cspwcspw/DIY_Constant_Load_Controller/Images/Amplify_and_level_shift.png

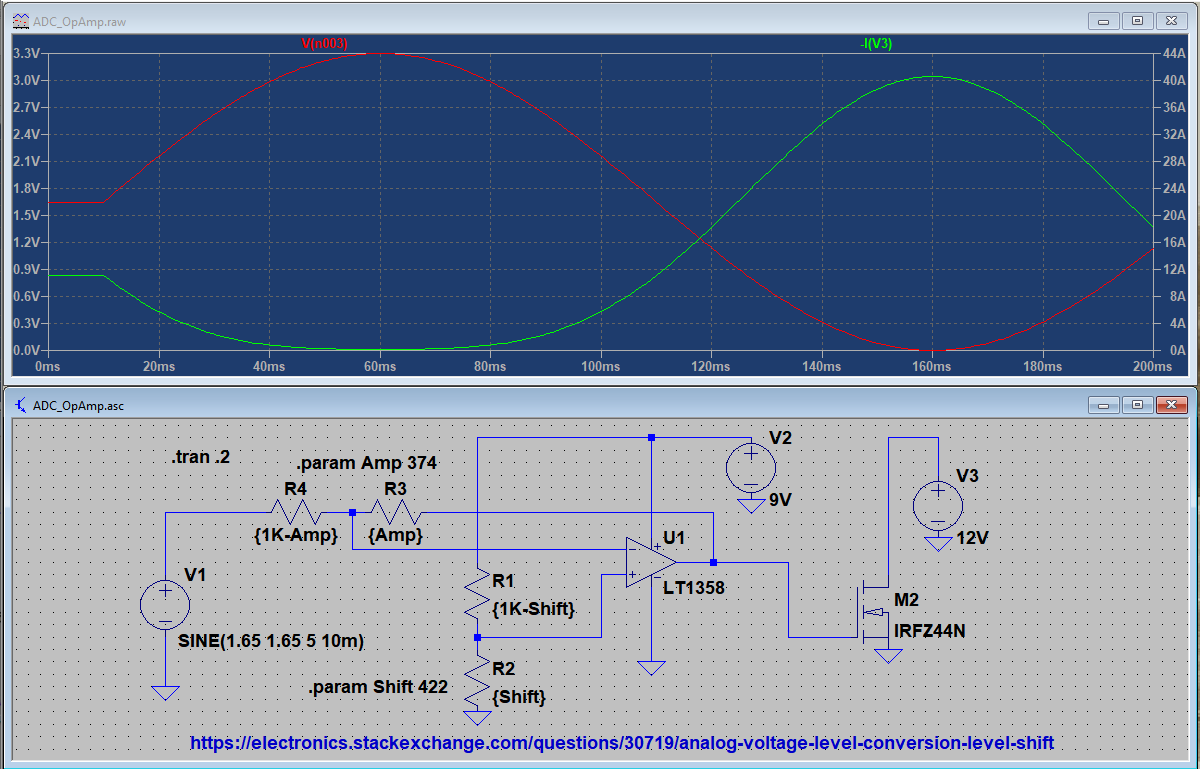
Images/Amplify_and_level_shift.png
