cspwcspw/DIY_Constant_Load_Controller/Images/Amplify_and_level_shift_low.png

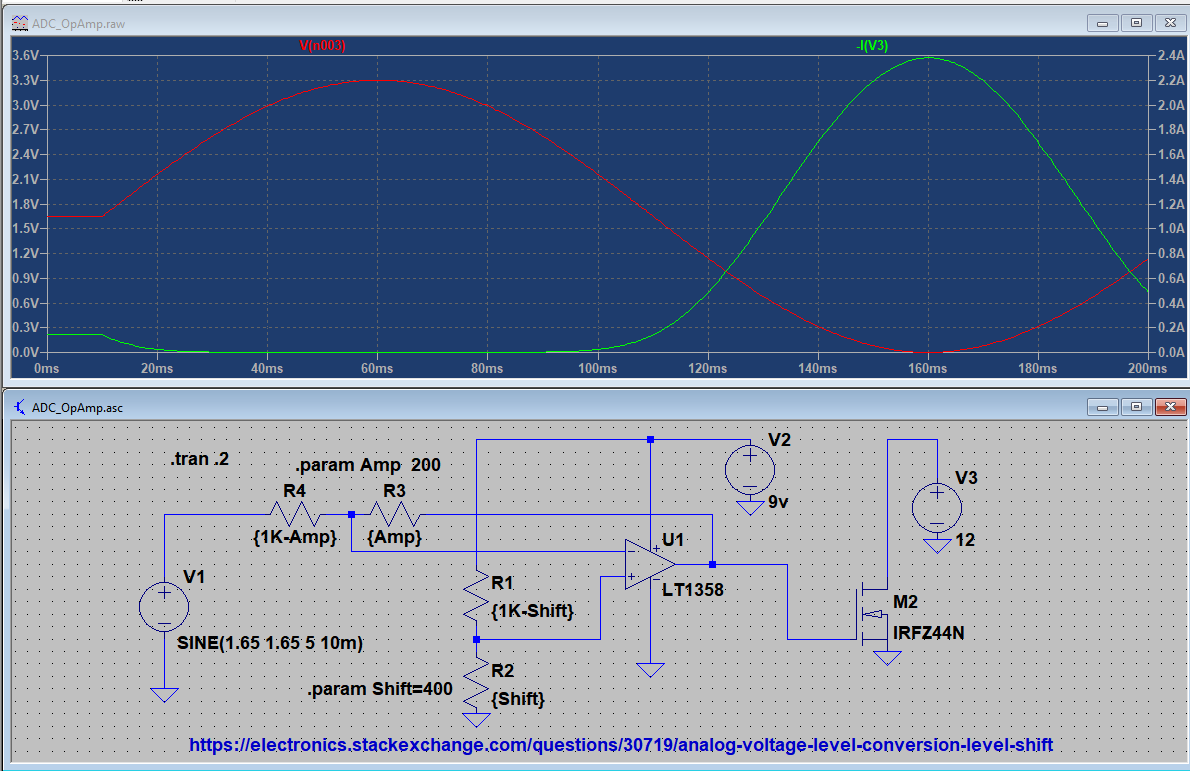
Images/Amplify_and_level_shift_low.png
