cspwcspw/DIY_Constant_Load_Controller/Images/DAC_NoAmp.png

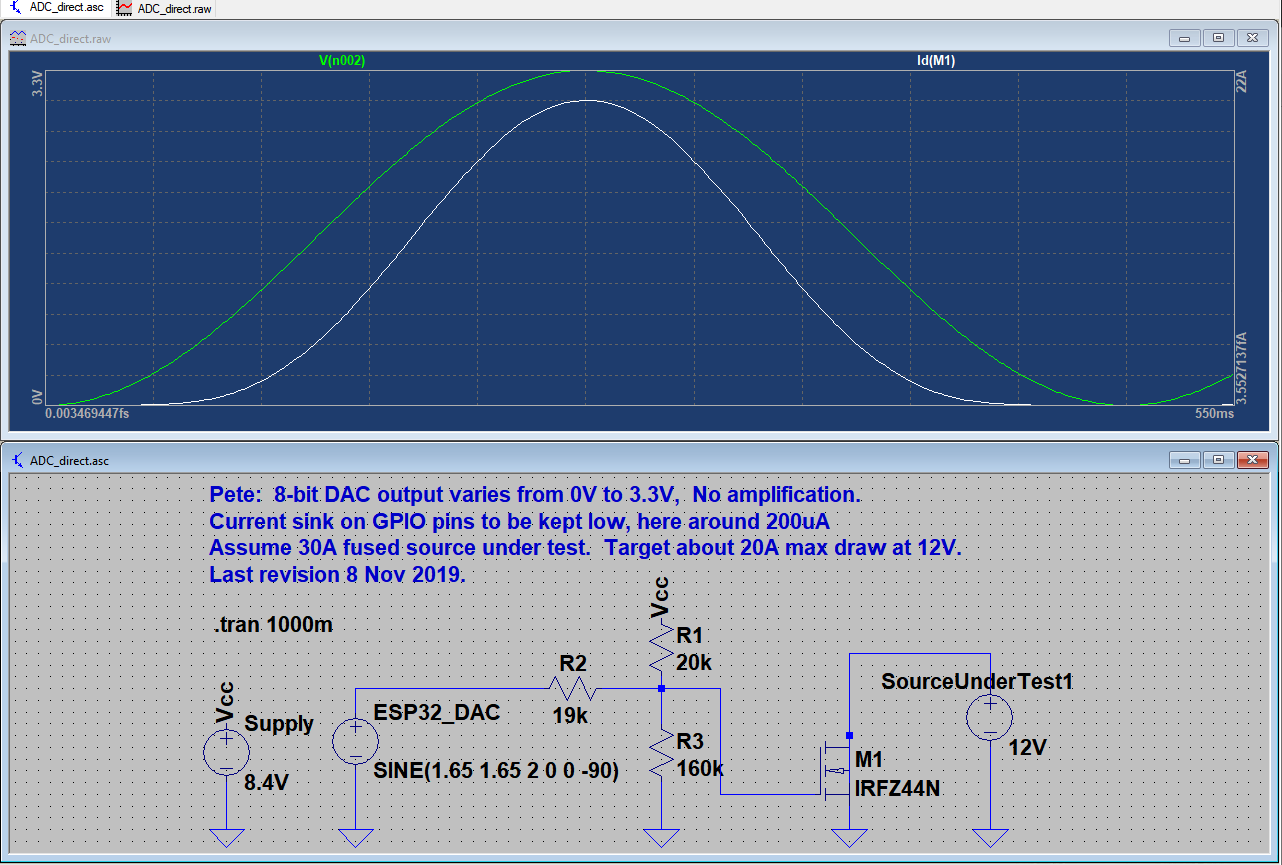
Images/DAC_NoAmp.png
