cspwcspw/DIY_Constant_Load_Controller/Images/NoAmp_PWM.png

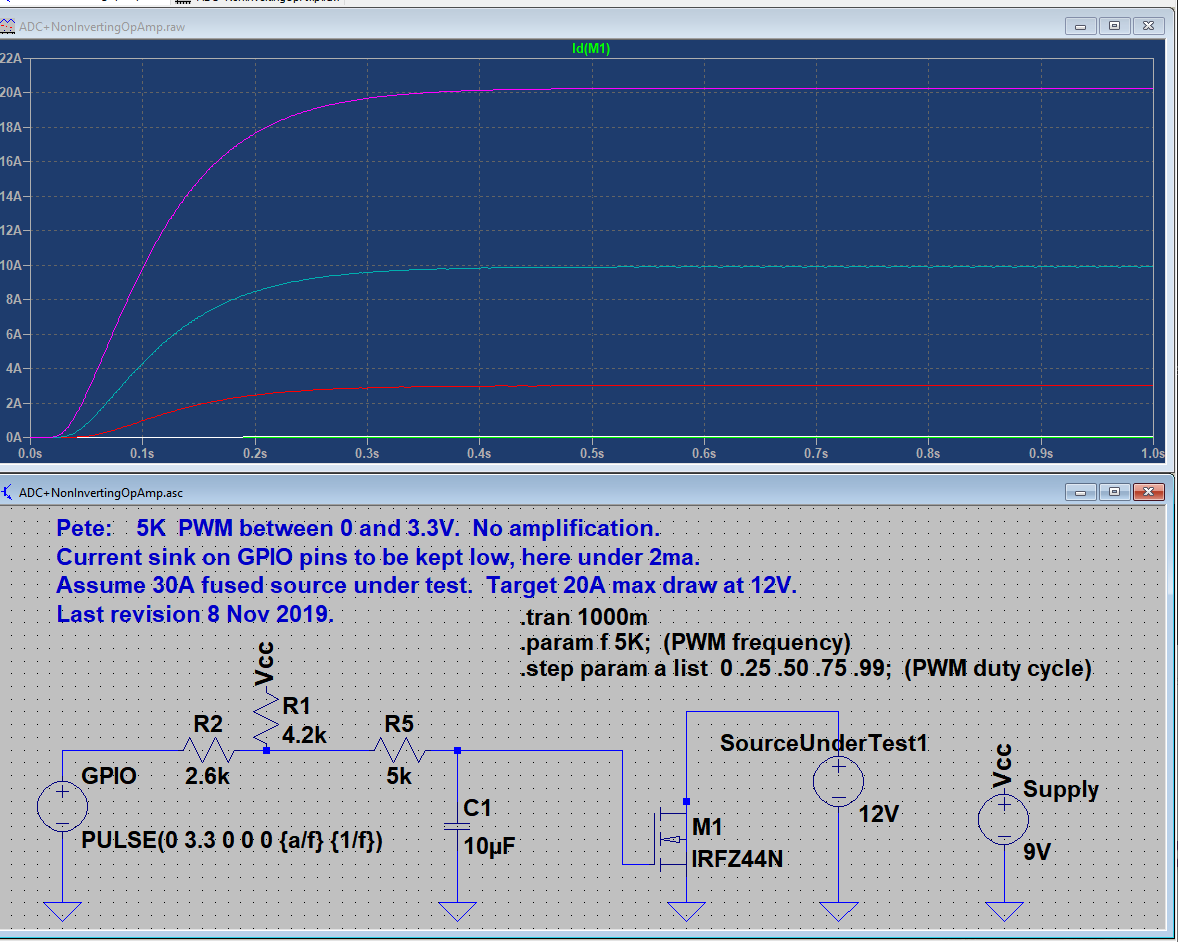
Images/NoAmp_PWM.png
