cspwcspw/DIY_Constant_Load_Controller/Images/Output_stage_circuit.png

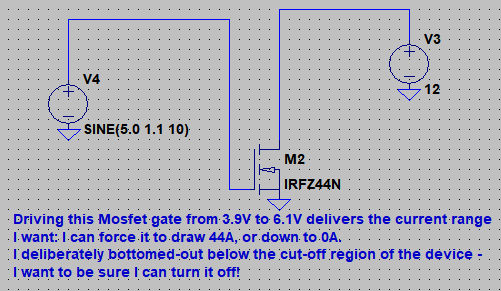
Images/Output_stage_circuit.png
