cspwcspw/DIY_Constant_Load_Controller/Images/Output_stage_graphs.png

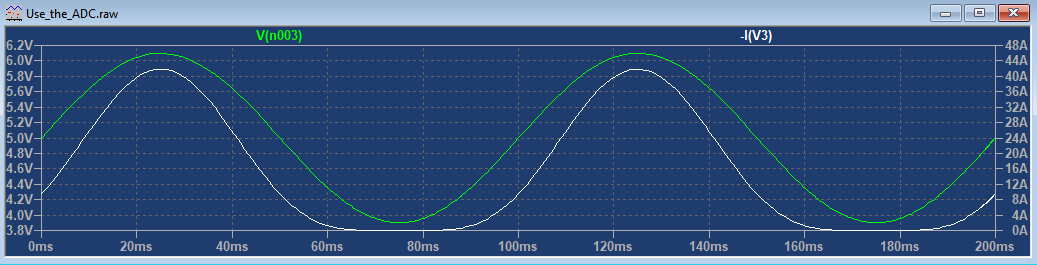
Images/Output_stage_graphs.png
