cspwcspw/DIY_Constant_Load_Controller/ConstCurrDriver.asc

C1: cap; 0.01µF
C2: cap; 0.01µF
C3: cap; 2.2µF
C4: cap; 2.2µF
GPIO1: voltage; PULSE(0 5 0 0 0 {a/f} {1/f})
M1: nmos; IRFZ44N
R1: res; 10K
R2: res; 39K
R3: res; 3.3k
R4: res; 680
R7: res; 680
Rf: res; 4.3k
Rg: res; 9.1K
S1: sw; reset
SourceUnderTest: voltage; 24V
U1: AD549
V1: voltage; PULSE(0 2 0 1ms 1ms 60ms 20s)
Vbias: voltage; 3.3V
Vcc: voltage; 9V
Named nets: 0, VGate, VControl
;    .include D:\\softworks\\LTspice_mods\\LM741.txt
Design based on Opamps For Everyone, Fig 4-10 (pg 39)
https://web.mit.edu/6.101/www/reference/op_amps_everyone.pdf
.tran 0.1s
.step param a list 0  0.50  .99;  (PWM duty cycle)
.param f=15.6K ;  (PWM frequency)
.model reset SW(Ron=1 Roff=1Meg Vt=1 Vh=-0.1)
Many LTSpice alternative opamps e.g. LT1001, LT1002, 
LT1007, AD549, opamp (ideal model), OP495, OP747, etc.
I used an LM358 in my build.
;    .include D:\\softworks\\LTspice_mods\\LM358.txt
