cspwcspw/DIY_Constant_Load_Controller/PWM_Voltage_Doubler.asc

C1: cap; 2.2µF
C2: cap; 470µF
C3: cap; 2.2µF
C4: cap; 470µF
D1: schottky; 1N5817
D2: schottky; 1N5817
D3: schottky; 1N5817
D4: schottky; 1N5817
Load1: res; 3.5K
Load: res; 3.5K
PWM: voltage; PULSE(0 5 0 0 0 {0.5/f} {1/f})
R1: res; 47
V1: voltage; 5v
Named nets: 0, V+, PWM, V-
.param f=15.6K ;  (PWM frequency)
.tran 0.5s
V >9v, I < 2ma needed to drive my LM358
MCU PWM voltage pump provides new power rails at low currents.
Load is dummy for these test harnesses.
